jngranger/blinkfyr/(commit log)

2026-11-01 Initial commit: ArduinoSyncBeeper hardware diagrams, docs, and dual firmware
2026-11-02 Add prototype photo, clean up schematic layout and labels, soften tone to simple DIY tutorial style
2026-11-03 Add Example 03: Fully manual AudioMoth & camera sync beacon (3x 0.5s pulses on button)
2026-11-09 Consolidate AudioMoth sync into Example 01 with dual PC-master / fallback clock sync and clean up examples
    [blinkfyr_log.csv]
